js0nnn/diy-power-quality-analyzer/docs/gui_main.png

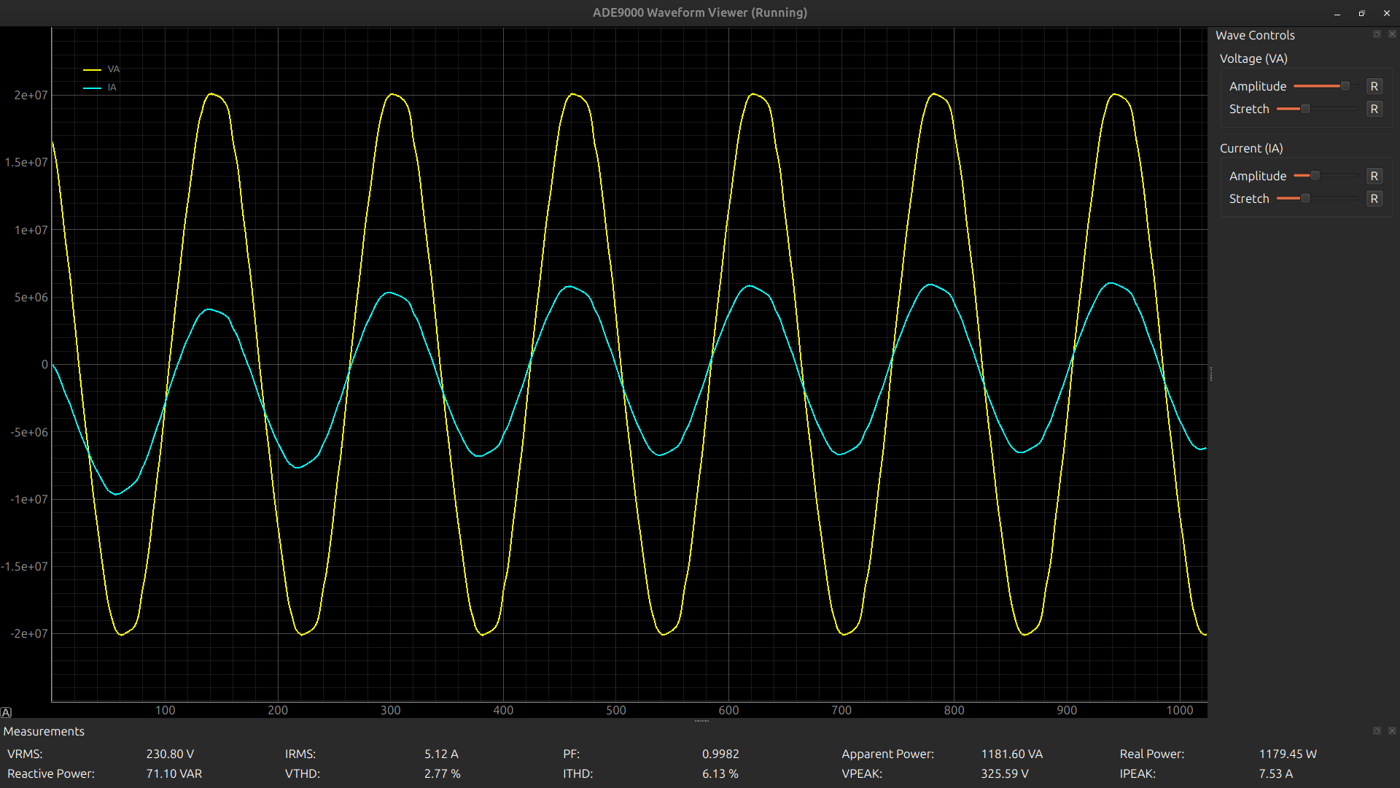
docs/gui_main.png
