js0nnn/diy-power-quality-analyzer/docs/hardware.jpg

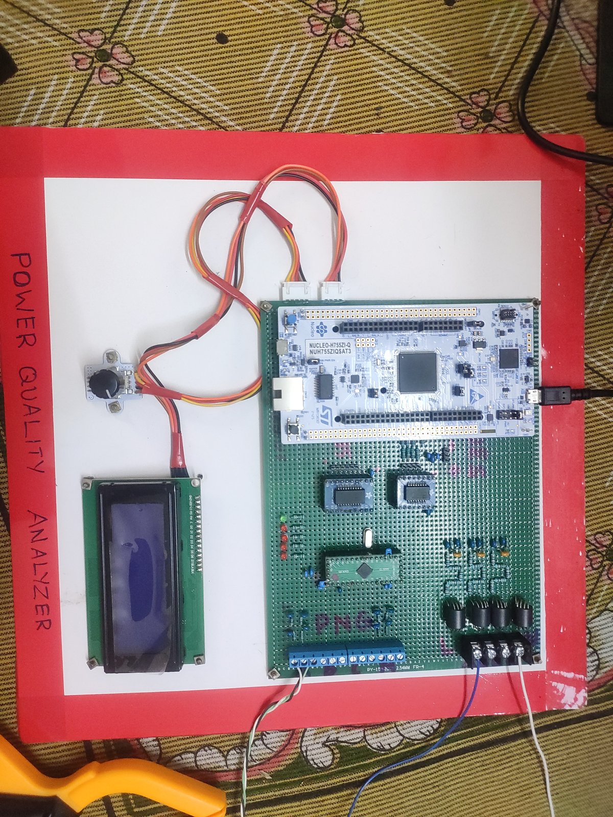
docs/hardware.jpg
