js0nnn/diy-power-quality-analyzer/ADE9000_PQA/ADE9000_PQA.ioc

Mcu.UserName=STM32H755ZITx
PA11.Signal=USB_OTG_FS_DM
PA12.Signal=USB_OTG_FS_DP
PA5.GPIO_Label=ADE9000_SPI1_SCK
PA5.Signal=SPI1_SCK
PA6.GPIO_Label=ADE9000_SPI1_MISO
PA6.Signal=SPI1_MISO
PA8.Signal=USB_OTG_FS_SOF
PA9.Signal=USB_OTG_FS_VBUS
PB0.GPIO_Label=CM7_LD1
PB0.Signal=GPIO_Output
PB10.GPIO_Label=LCD_SCL
PB10.Signal=I2C2_SCL
PB11.GPIO_Label=LCD_SDA
PB11.Signal=I2C2_SDA
PB5.GPIO_Label=ADE9000_SPI1_MOSI
PB5.Signal=SPI1_MOSI
PB6.GPIO_Label=ENCODER_A
PB6.Signal=S_TIM4_CH1
PB7.GPIO_Label=ENCODER_B
PB7.Signal=S_TIM4_CH2
PB8.GPIO_Label=ADE9000_IRQ0
PB8.Signal=GPXTI8
PB9.GPIO_Label=ADE9000_IRQ1
PB9.Signal=GPIO_Input
PC13.Signal=GPIO_Input
PC7.GPIO_Label=ADE9000_ZX
PC7.Signal=GPIO_Input
PD10.GPIO_Label=USB_OTG_FS_PWR_EN
PD10.Signal=GPIO_Output
PD14.GPIO_Label=ADE9000_SPI1_CS
PD14.Signal=GPIO_Output
PD15.GPIO_Label=ADE9000_RESET
PD15.Signal=GPIO_Output
PD5.Signal=USART2_TX
PD6.Signal=USART2_RX
PD7.GPIO_Label=ESP01_RST
PD7.Signal=GPIO_Output
PD8.Signal=USART3_TX
PD9.Signal=USART3_RX
PE11.GPIO_Label=ADE9000_DREADY_INT
PE11.Signal=GPXTI11
PG13.Signal=ETH_TXD0
PG14.GPIO_Label=ENCODER_SW
PG14.Signal=GPXTI14
PG7.GPIO_Label=USB_OTG_FS_OVCR
PG7.Signal=GPXTI7
PG9.GPIO_Label=ADE9000_PM1
PG9.Signal=GPIO_Output
