js0nnn/diy-power-quality-analyzer/ADE9000_PQA/CM7/Core/Inc/main.h

#define ADE9000_SPI1_SCK_Pin GPIO_PIN_5
#define ADE9000_SPI1_SCK_GPIO_Port GPIOA
#define ADE9000_SPI1_MISO_Pin GPIO_PIN_6
#define ADE9000_SPI1_MISO_GPIO_Port GPIOA
#define CM7_LD1_Pin GPIO_PIN_0
#define CM7_LD1_GPIO_Port GPIOB
#define ADE9000_DREADY_INT_Pin GPIO_PIN_11
#define ADE9000_DREADY_INT_GPIO_Port GPIOE
#define ADE9000_DREADY_INT_EXTI_IRQn EXTI15_10_IRQn
#define ADE9000_SPI1_CS_Pin GPIO_PIN_14
#define ADE9000_SPI1_CS_GPIO_Port GPIOD
#define ADE9000_RESET_Pin GPIO_PIN_15
#define ADE9000_RESET_GPIO_Port GPIOD
#define ADE9000_PM1_Pin GPIO_PIN_9
#define ADE9000_PM1_GPIO_Port GPIOG
#define ADE9000_SPI1_MOSI_Pin GPIO_PIN_5
#define ADE9000_SPI1_MOSI_GPIO_Port GPIOB
#define ADE9000_IRQ0_Pin GPIO_PIN_8
#define ADE9000_IRQ0_GPIO_Port GPIOB
#define ADE9000_IRQ0_EXTI_IRQn EXTI9_5_IRQn
