js0nnn/diy-power-quality-analyzer/ADE9000_PQA/Common/Src/esp01_drivers/ESP8266_STM32.c

#include "ESP8266_STM32.h"


ESP8266_ConnectionState ESP_ConnState = ESP8266_DISCONNECTED;   // Default state
static char esp_rx_buffer[2048];
static ESP8266_Status ESP_GetIP(char *ip_buffer, uint16_t buffer_len);
static ESP8266_Status ESP_SendCommand(const char *cmd, const char *ack, uint32_t timeout);

void ESP_Flush(void)
{
    uint8_t ch;
    while (HAL_UART_Receive(&ESP_UART, &ch, 1, 5) == HAL_OK);
}

ESP8266_Status ESP_Init(void)
{
	ESP8266_Status res;
	USER_LOG("Initializing ESP8266...");
	HAL_Delay(1000);

	ESP_Flush();
//	res = ESP_SendCommand("AT+RST\r\n", "OK", 2000);
//    if (res != ESP8266_OK){
//    	DEBUG_LOG("Failed to Reset ESP8266...");
//    	return res;
//    }
//
//    USER_LOG("Waiting 5 Seconds for Reset to Complete...");
//    HAL_Delay(5000);  // wait for reset to complete

    res = ESP_SendCommand("AT\r\n", "OK", 2000);
    if (res != ESP8266_OK){
    	DEBUG_LOG("ESP8266 Not Responding...");
    	return res;
    }

    res = ESP_SendCommand("ATE0\r\n", "OK", 2000); // Disable echo
    if (res != ESP8266_OK){
    	DEBUG_LOG("Disable echo Command Failed...");
    	return res;
    }
    USER_LOG("ESP8266 Initialized Successfully...");
    return ESP8266_OK;
}



ESP8266_Status ESP_MQTT_Publish(const char *topic, const char *payload, uint8_t qos, uint8_t retain)
{

	if (strlen(payload) > 100)
	{
		DEBUG_LOG("Payload too long!\r\n");
	    return ESP8266_ERROR;
	}

    char cmd[512];

    snprintf(cmd, sizeof(cmd),
             "AT+MQTTPUB=0,\"%s\",\"%s\",%d,%d\r\n",
             topic,
             payload,
             qos,
             retain);

    return ESP_SendCommand(cmd, "OK", 5000);
}


ESP8266_Status ESP_MQTT_Connect(const char *client_id,
                               const char *broker_ip,
                               uint16_t port)
{
    char cmd[256];

    USER_LOG("Starting MQTT Setup...");

    /* Single connection mode */
    if (ESP_SendCommand("AT+CIPMUX=0\r\n", "OK", 2000) != ESP8266_OK)
    {
        USER_LOG("CIPMUX failed");
        return ESP8266_ERROR;
    }

    /* Clean previous MQTT session */
    ESP_SendCommand("AT+MQTTCLEAN=0\r\n", "OK", 2000);

    /* Configure MQTT client */
    snprintf(cmd, sizeof(cmd),
             "AT+MQTTUSERCFG=0,1,\"%s\",\"\",\"\",0,0,\"\"\r\n",
             client_id);

    if (ESP_SendCommand(cmd, "OK", 3000) != ESP8266_OK)
    {
        USER_LOG("MQTT USERCFG failed");
        return ESP8266_ERROR;
    }

    /* Connect to broker */
    snprintf(cmd, sizeof(cmd),
             "AT+MQTTCONN=0,\"%s\",%d,0\r\n",
             broker_ip, port);

    if (ESP_SendCommand(cmd, "OK", 8000) != ESP8266_OK)
    {
        USER_LOG("MQTT connection failed");
        return ESP8266_ERROR;
    }

    USER_LOG("MQTT Connected to %s:%d", broker_ip, port);

    return ESP8266_OK;
}


ESP8266_Status ESP_ConnectWiFi(const char *ssid, const char *password, char *ip_buffer, uint16_t buffer_len)
{
    USER_LOG("Setting in Station Mode");
    // reset WiFi
//    ESP_SendCommand("AT+CWQAP\r\n", "OK", 2000);
    // Set in Station Mode
    char cmd[128];
    snprintf(cmd, sizeof(cmd), "AT+CWMODE=1\r\n");

    ESP8266_Status result = ESP_SendCommand(cmd, "OK", 2000); // wait up to 2s
    if (result != ESP8266_OK)
    {
    	USER_LOG("Station Mode Failed.");
        return result;
    }
    
    USER_LOG("Connecting to WiFi SSID: %s", ssid);
    // Send join command
    snprintf(cmd, sizeof(cmd), "AT+CWJAP=\"%s\",\"%s\"\r\n", ssid, password);

    result = ESP_SendCommand(cmd, "WIFI CONNECTED", 10000); // wait up to 10s
    if (result != ESP8266_OK)
    {
    	USER_LOG("WiFi connection failed.");
        ESP_ConnState = ESP8266_NOT_CONNECTED;
        return result;
    }

    USER_LOG("WiFi Connected. Waiting for IP...");
    ESP_ConnState = ESP8266_CONNECTED_NO_IP;
    // Fetch IP with retries inside ESP_GetIP
    result = ESP_GetIP(ip_buffer, buffer_len);
    if (result != ESP8266_OK)
    {
    	USER_LOG("Failed to fetch IP. Status=%d", result);
        return result;
    }

    USER_LOG("WiFi + IP ready: %s", ip_buffer);
    return ESP8266_OK;
}

ESP8266_ConnectionState ESP_GetConnectionState(void)
{
    return ESP_ConnState;
}

static ESP8266_Status ESP_GetIP(char *ip_buffer, uint16_t buffer_len)
{
	DEBUG_LOG("Fetching IP Address...");

    for (int attempt = 1; attempt <= 3; attempt++)
    {
        ESP8266_Status result = ESP_SendCommand("AT+CIFSR\r\n", "OK", 5000);
        if (result != ESP8266_OK)
        {
        	DEBUG_LOG("CIFSR failed on attempt %d", attempt);
            continue;
        }

        char *search = esp_rx_buffer;
        char *last_ip = NULL;

        while ((search = strstr(search, "STAIP,")) != NULL)
        {
            char *ip_start = strstr(search, "STAIP,\"");
            if (ip_start)
            {
                ip_start += 7;
                char *end = strchr(ip_start, '"');
                if (end && ((end - ip_start) < buffer_len))
                {
                    last_ip = ip_start;
                }
            }
            search += 6;
        }

        if (last_ip)
        {
            char *end = strchr(last_ip, '"');
            strncpy(ip_buffer, last_ip, end - last_ip);
            ip_buffer[end - last_ip] = '\0';

            if (strcmp(ip_buffer, "0.0.0.0") == 0)
            {
            	DEBUG_LOG("Attempt %d: IP not ready yet (0.0.0.0). Retrying...", attempt);
                ESP_ConnState = ESP8266_CONNECTED_NO_IP;
                HAL_Delay(1000);
                continue;
            }

            DEBUG_LOG("Got IP: %s", ip_buffer);
            ESP_ConnState = ESP8266_CONNECTED_IP;
            return ESP8266_OK;
        }

        DEBUG_LOG("Attempt %d: Failed to parse STAIP.", attempt);
        HAL_Delay(500);
    }

    DEBUG_LOG("Failed to fetch IP after retries.");
    ESP_ConnState = ESP8266_CONNECTED_NO_IP;  // still connected, but no IP
    return ESP8266_ERROR;
}

static ESP8266_Status ESP_SendCommand(const char *cmd, const char *ack, uint32_t timeout)
{
    uint8_t ch;
    uint16_t idx = 0;
    uint32_t tickstart;
    int found = 0;

    memset(esp_rx_buffer, 0, sizeof(esp_rx_buffer));
    tickstart = HAL_GetTick();

    if (strlen(cmd) > 0)
    {
        DEBUG_LOG("Sending: %s", cmd);
        if (HAL_UART_Transmit(&ESP_UART, (uint8_t*)cmd, strlen(cmd), HAL_MAX_DELAY) != HAL_OK)
            return ESP8266_ERROR;
    }

    while ((HAL_GetTick() - tickstart) < timeout && idx < sizeof(esp_rx_buffer) - 1)
    {
        if (HAL_UART_Receive(&ESP_UART, &ch, 1, 10) == HAL_OK)
        {
            esp_rx_buffer[idx++] = ch;
            esp_rx_buffer[idx]   = '\0';

            // check for ACK
            if (!found && strstr(esp_rx_buffer, ack))
            {
                DEBUG_LOG("Matched ACK: %s", ack);
                found = 1; // mark as found but keep reading
            }

            // handle busy response
            if (strstr(esp_rx_buffer, "busy"))
            {
                DEBUG_LOG("ESP is busy... delaying before retry");
                HAL_Delay(1500);
                idx = 0;
                memset(esp_rx_buffer, 0, sizeof(esp_rx_buffer));
                continue;
            }
        }
    }

    if (found)
    {
        DEBUG_LOG("Full buffer: %s", esp_rx_buffer);
        return ESP8266_OK;
    }

    if (idx == 0)
        return ESP8266_NO_RESPONSE;

    DEBUG_LOG("Timeout or no ACK. Buffer: %s", esp_rx_buffer);
    return ESP8266_TIMEOUT;
}
