js0nnn/diy-power-quality-analyzer/ADE9000_PQA/Common/Src/ade9000_drivers/no_os_util.c

/***************************************************************************//**
 *   @file   no_os_util.c
 *   @brief  Implementation of utility functions.
 *   @author DBogdan (dragos.bogdan@analog.com)
********************************************************************************
 * Copyright 2018(c) Analog Devices, Inc.
 *
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
 * 3. Neither the name of Analog Devices, Inc. nor the names of its
 *    contributors may be used to endorse or promote products derived from this
 *    software without specific prior written permission.
 *
 * THIS SOFTWARE IS PROVIDED BY ANALOG DEVICES, INC. “AS IS” AND ANY EXPRESS OR
 * IMPLIED WARRANTIES, INCLUDING, BUT NOT LIMITED TO, THE IMPLIED WARRANTIES OF
 * MERCHANTABILITY AND FITNESS FOR A PARTICULAR PURPOSE ARE DISCLAIMED. IN NO
 * EVENT SHALL ANALOG DEVICES, INC. BE LIABLE FOR ANY DIRECT, INDIRECT,
 * INCIDENTAL, SPECIAL, EXEMPLARY, OR CONSEQUENTIAL DAMAGES (INCLUDING, BUT NOT
 * LIMITED TO, PROCUREMENT OF SUBSTITUTE GOODS OR SERVICES; LOSS OF USE, DATA,
 * OR PROFITS; OR BUSINESS INTERRUPTION) HOWEVER CAUSED AND ON ANY THEORY OF
 * LIABILITY, WHETHER IN CONTRACT, STRICT LIABILITY, OR TORT (INCLUDING
 * NEGLIGENCE OR OTHERWISE) ARISING IN ANY WAY OUT OF THE USE OF THIS SOFTWARE,
 * EVEN IF ADVISED OF THE POSSIBILITY OF SUCH DAMAGE.
*******************************************************************************/

#include "no_os_util.h"

#include <string.h>
#include <stdlib.h>
#include "errno.h"
extern int no_os_test_bit(int pos, const volatile void * addr);

/**
 * Find first set bit in word.
 */
uint32_t no_os_find_first_set_bit(uint32_t word)
{
	uint32_t first_set_bit = 0;

	while (word) {
		if (word & 0x1)
			return first_set_bit;
		word >>= 1;
		first_set_bit ++;
	}

	return 32;
}

/**
 * Find first set bit in word.
 */
uint64_t no_os_find_first_set_bit_u64(uint64_t word)
{
	uint64_t first_set_bit = 0;

	while (word) {
		if (word & 0x1)
			return first_set_bit;
		word >>= 1;
		first_set_bit ++;
	}

	return 64;
}

/**
 * Find last set bit in word.
 */
uint32_t no_os_find_last_set_bit(uint32_t word)
{
	uint32_t bit = 0;
	uint32_t last_set_bit = 32;

	while (word) {
		if (word & 0x1)
			last_set_bit = bit;
		word >>= 1;
		bit ++;
	}

	return last_set_bit;
}

/**
 * Find last set bit in word.
 */
uint64_t no_os_find_last_set_bit_u64(uint64_t word)
{
	uint64_t bit = 0;
	uint64_t last_set_bit = 64;

	while (word) {
		if (word & 0x1)
			last_set_bit = bit;
		word >>= 1;
		bit ++;
	}

	return last_set_bit;
}

/**
 * Locate the closest element in an array.
 */
uint32_t no_os_find_closest(int32_t val,
			    const int32_t *array,
			    uint32_t size)
{
	int32_t diff = abs(array[0] - val);
	uint32_t ret = 0;
	uint32_t i;

	for (i = 1; i < size; i++) {
		if (abs(array[i] - val) < diff) {
			diff = abs(array[i] - val);
			ret = i;
		}
	}

	return ret;
}

/**
 * Shift the value and apply the specified mask.
 */
uint32_t no_os_field_prep(uint32_t mask, uint32_t val)
{
	return (val << no_os_find_first_set_bit(mask)) & mask;
}

uint64_t no_os_field_prep_u64(uint64_t mask, uint64_t val)
{
	return (val << no_os_find_first_set_bit_u64(mask)) & mask;
}

/**
 * Get a field specified by a mask from a word.
 */
uint32_t no_os_field_get(uint32_t mask, uint32_t word)
{
	return (word & mask) >> no_os_find_first_set_bit(mask);
}

/**
 * Produce the maximum value representable by a field
 */
uint32_t no_os_field_max(uint32_t mask)
{
	// Find the first set bit to determine the shift position
	uint32_t first_set_bit = no_os_find_first_set_bit(mask);

	// Shift the mask to the right by the position of the first set bit
	uint32_t shifted_mask = mask >> first_set_bit;

	return shifted_mask;
}

/**
 * Produce the maximum value representable by a field
 */
uint64_t no_os_field_max_u64(uint64_t mask)
{
	// Find the first set bit to determine the shift position
	uint64_t first_set_bit = no_os_find_first_set_bit_u64(mask);

	// Shift the mask to the right by the position of the first set bit
	uint64_t shifted_mask = mask >> first_set_bit;

	return shifted_mask;
}


/**
 * Log base 2 of the given number.
 */
int32_t no_os_log_base_2(uint32_t x)
{
	return no_os_find_last_set_bit(x);
}

/**
 * Find greatest common divisor of the given two numbers.
 */
uint32_t no_os_greatest_common_divisor(uint32_t a,
				       uint32_t b)
{
	uint32_t div;

	if ((a == 0) || (b == 0))
		return no_os_max(a, b);

	while (b != 0) {
		div = a % b;
		a = b;
		b = div;
	}

	return a;
}

uint64_t no_os_greatest_common_divisor_u64(uint64_t a,
		uint64_t b)
{
	uint64_t div;

	if ((a == 0) || (b == 0))
		return no_os_max(a, b);

	while (b != 0) {
		div = a % b;
		a = b;
		b = div;
	}

	return a;
}

/**
 * Find lowest common multiple of the given two numbers.
 */
uint32_t no_os_lowest_common_multiple(uint32_t a, uint32_t b)
{
	if (a && b)
		return (a / no_os_greatest_common_divisor(a, b)) * b;
	else
		return 0;
}

/**
 * Calculate best rational approximation for a given fraction.
 */
void no_os_rational_best_approximation(uint32_t given_numerator,
				       uint32_t given_denominator,
				       uint32_t max_numerator,
				       uint32_t max_denominator,
				       uint32_t *best_numerator,
				       uint32_t *best_denominator)
{
	uint32_t gcd;

	gcd = no_os_greatest_common_divisor(given_numerator, given_denominator);

	*best_numerator = given_numerator / gcd;
	*best_denominator = given_denominator / gcd;

	if ((*best_numerator > max_numerator) ||
	    (*best_denominator > max_denominator)) {
		*best_numerator = 0;
		*best_denominator = 0;
	}
}

void no_os_rational_best_approximation_u64(uint64_t given_numerator,
		uint64_t given_denominator,
		uint64_t max_numerator,
		uint64_t max_denominator,
		uint64_t *best_numerator,
		uint64_t *best_denominator)
{
	uint64_t gcd;

	gcd = no_os_greatest_common_divisor_u64(given_numerator, given_denominator);

	*best_numerator = given_numerator / gcd;
	*best_denominator = given_denominator / gcd;

	if ((*best_numerator > max_numerator) ||
	    (*best_denominator > max_denominator)) {
		*best_numerator = 0;
		*best_denominator = 0;
	}
}

/**
 * Calculate the number of set bits (8-bit size).
 */
unsigned int no_os_hweight8(uint8_t word)
{
	uint32_t count = 0;

	while (word) {
		if (word & 0x1)
			count++;
		word >>= 1;
	}

	return count;
}

/**
 * Calculate the number of set bits (16-bit size).
 */
unsigned int no_os_hweight16(uint16_t word)
{
	return no_os_hweight8(word >> 8) +
	       no_os_hweight8(word);
}

/**
 * Calculate the number of set bits (32-bit size).
 */
unsigned int no_os_hweight32(uint32_t word)
{
	return no_os_hweight16(word >> 16) +
	       no_os_hweight16(word);
}

/**
 * Calculate the quotient and the remainder of an integer division.
 */
uint64_t no_os_do_div(uint64_t* n,
		      uint64_t base)
{
	uint64_t mod = 0;

	mod = *n % base;
	*n = *n / base;

	return mod;
}

/**
 * Unsigned 64bit divide with 64bit divisor and remainder
 */
uint64_t no_os_div64_u64_rem(uint64_t dividend, uint64_t divisor,
			     uint64_t *remainder)
{
	*remainder = dividend % divisor;

	return dividend / divisor;
}

/**
 * Unsigned 64bit divide with 32bit divisor with remainder
 */
uint64_t no_os_div_u64_rem(uint64_t dividend, uint32_t divisor,
			   uint32_t *remainder)
{
	*remainder = no_os_do_div(&dividend, divisor);

	return dividend;
}

/**
 * Signed 64bit divide with 32bit divisor with remainder
 */
int64_t no_os_div_s64_rem(int64_t dividend, int32_t divisor, int32_t *remainder)
{
	*remainder = dividend % divisor;
	return dividend / divisor;
}

/**
 * Unsigned 64bit divide with 32bit divisor
 */
uint64_t no_os_div_u64(uint64_t dividend, uint32_t divisor)
{
	uint32_t remainder;

	return no_os_div_u64_rem(dividend, divisor, &remainder);
}

/**
 * Signed 64bit divide with 32bit divisor
 */
int64_t no_os_div_s64(int64_t dividend, int32_t divisor)
{
	int32_t remainder;
	return no_os_div_s64_rem(dividend, divisor, &remainder);
}

/**
 * Converts from string to int32_t
 * @param *str
 * @return int32_t
 */
int32_t no_os_str_to_int32(const char *str)
{
	char *end;
	int32_t value = strtol(str, &end, 0);

	if (end == str)
		return -EINVAL;
	else
		return value;
}

/**
 * Converts from string to uint32_t
 * @param *str
 * @return uint32_t
 */
uint32_t no_os_str_to_uint32(const char *str)
{
	char *end;
	uint32_t value = strtoul(str, &end, 0);

	if (end == str)
		return -EINVAL;
	else
		return value;
}

void no_os_put_unaligned_be16(uint16_t val, uint8_t *buf)
{
	buf[1] = val & 0xFF;
	buf[0] = val >> 8;
}

uint16_t no_os_get_unaligned_be16(uint8_t *buf)
{
	return buf[1] | ((uint16_t)buf[0] << 8);
}

void no_os_put_unaligned_le16(uint16_t val, uint8_t *buf)
{
	buf[0] = val & 0xFF;
	buf[1] = val >> 8;
}

uint16_t no_os_get_unaligned_le16(uint8_t *buf)
{
	return buf[0] | ((uint16_t)buf[1] << 8);
}

void no_os_put_unaligned_be24(uint32_t val, uint8_t *buf)
{
	buf[2] = val & 0xFF;
	buf[1] = (val >> 8) & 0xFF;
	buf[0] = val >> 16;
}

uint32_t no_os_get_unaligned_be24(uint8_t *buf)
{
	return buf[2] | ((uint16_t)buf[1] << 8) | ((uint32_t)buf[0] << 16);
}

void no_os_put_unaligned_le24(uint32_t val, uint8_t *buf)
{
	buf[0] = val & 0xFF;
	buf[1] = (val >> 8) & 0xFF;
	buf[2] = val >> 16;
}

uint32_t no_os_get_unaligned_le24(uint8_t *buf)
{
	return buf[0] | ((uint16_t)buf[1] << 8) | ((uint32_t)buf[2] << 16);
}

void no_os_put_unaligned_be32(uint32_t val, uint8_t *buf)
{
	buf[3] = val & 0xFF;
	buf[2] = (val >> 8) & 0xFF;
	buf[1] = (val >> 16) & 0xFF;
	buf[0] = val >> 24;
}

uint32_t no_os_get_unaligned_be32(uint8_t *buf)
{
	return buf[3] | ((uint16_t)buf[2] << 8) | ((uint32_t)buf[1] << 16)
	       | ((uint32_t)buf[0] << 24);
}

void no_os_put_unaligned_le32(uint32_t val, uint8_t *buf)
{
	buf[0] = val & 0xFF;
	buf[1] = (val >> 8) & 0xFF;
	buf[2] = (val >> 16) & 0xFF;
	buf[3] = val >> 24;
}

uint32_t no_os_get_unaligned_le32(uint8_t *buf)
{
	return buf[0] | ((uint16_t)buf[1] << 8) | ((uint32_t)buf[2] << 16)
	       | ((uint32_t)buf[3] << 24);
}

void no_os_put_unaligned_be64(uint64_t val, uint8_t *buf)
{
	buf[7] = val & 0xFF;
	buf[6] = (val >> 8) & 0xFF;
	buf[5] = (val >> 16) & 0xFF;
	buf[4] = (val >> 24) & 0xFF;
	buf[3] = (val >> 32) & 0xFF;
	buf[2] = (val >> 40) & 0xFF;
	buf[1] = (val >> 48) & 0xFF;
	buf[0] = val >> 56;
}

uint64_t no_os_get_unaligned_be64(uint8_t *buf)
{
	return buf[7] | ((uint16_t)buf[6] << 8) | ((uint32_t)buf[5] << 16)
	       | ((uint32_t)buf[4] << 24) | ((uint64_t)buf[3] << 32)
	       | ((uint64_t)buf[2] << 40) | ((uint64_t)buf[1] << 48)
	       | ((uint64_t)buf[0] << 56);
}

void no_os_put_unaligned_le64(uint64_t val, uint8_t *buf)
{
	buf[0] = val & 0xFF;
	buf[1] = (val >> 8) & 0xFF;
	buf[2] = (val >> 16) & 0xFF;
	buf[3] = (val >> 24) & 0xFF;
	buf[4] = (val >> 32) & 0xFF;
	buf[5] = (val >> 40) & 0xFF;
	buf[6] = (val >> 48) & 0xFF;
	buf[7] = val >> 56;
}

uint64_t no_os_get_unaligned_le64(uint8_t *buf)
{
	return buf[0] | ((uint16_t)buf[1] << 8) | ((uint32_t)buf[2] << 16)
	       | ((uint32_t)buf[3] << 24) | ((uint64_t)buf[4] << 32)
	       | ((uint64_t)buf[5] << 40) | ((uint64_t)buf[6] << 48)
	       | ((uint64_t)buf[7] << 56);
}

int16_t no_os_sign_extend16(uint16_t value, int index)
{
	uint8_t shift = 15 - index;
	return (int16_t)(value << shift) >> shift;
}

int32_t no_os_sign_extend32(uint32_t value, int index)
{
	uint8_t shift = 31 - index;
	return (int32_t)(value << shift) >> shift;
}

uint64_t no_os_mul_u32_u32(uint32_t a, uint32_t b)
{
	return (uint64_t)a * b;
}

uint64_t no_os_mul_u64_u32_shr(uint64_t a, uint32_t mul, unsigned int shift)
{
	uint32_t ah, al;
	uint64_t ret;

	al = a;
	ah = a >> 32;

	ret = no_os_mul_u32_u32(al, mul) >> shift;
	if (ah)
		ret += no_os_mul_u32_u32(ah, mul) << (32 - shift);

	return ret;
}

uint64_t no_os_mul_u64_u32_div(uint64_t a, uint32_t mul, uint32_t divisor)
{
	int i;
	uint64_t low, high, temp, rem;
	uint32_t a_high = a >> 32;
	uint32_t a_low = a & 0xFFFFFFFF;
	uint64_t result = 0;
	uint64_t low_low = no_os_mul_u32_u32(a_low, mul);
	uint64_t high_low =  no_os_mul_u32_u32(a_high, mul);

	low = low_low + ((high_low & 0xFFFFFFFF) << 32);
	high = (high_low >> 32) + (low_low >> 32);

	rem = high;

	for (i = 0; i < 64; i++) {
		/* Shift remainder left and add the next bit from low */
		rem = (rem << 1) | (low >> 63);
		low <<= 1;

		/* Compare the remainder with the divisor */
		if (rem >= divisor) {
			rem -= divisor;
			temp = (uint64_t)1 << (63 - i);
			result |= temp;
		}
	}
	return result;
}

/**
 * @brief Check big endianess of the host processor.
 * @return Big endianess status (true/false)
 */
bool no_os_is_big_endian(void)
{
	uint16_t a = 0x0100;
	return (bool) * (uint8_t *)&a;
}

/* @brief Swap bytes in a buffer with a given step
 *        Swap with step of 2:
 *        AA BB CC DD EE FF 00 11 becomes
 *        BB AA DD CC FF EE 11 00
 *        Swap with step of 3:
 *        AA BB CC DD EE FF 00 11 22 becomes
 *        CC BB AA FF EE DD 22 11 00
 *        etc.
 * @param buf - Input buffer to be swapped.
 * @param bytes - Number of bytes.
 * @param step - Number of steps.
 * @return None
 */
void no_os_memswap64(void *buf, uint32_t bytes, uint32_t step)
{
	uint8_t * p = buf;
	uint32_t i, j;
	uint8_t temp[8];

	if (step < 2 || step > 8 || bytes < step || bytes % step != 0)
		return;

	for (i = 0; i < bytes; i += step) {
		memcpy(temp, p, step);
		for (j = step; j > 0; j--) {
			*p++ = temp[j - 1];
		}
	}
}
