js0nnn/diy-power-quality-analyzer/(commit log)

2026-10-17 Initial commit: DIY power quality analyzer
    Hand-soldered ADE9000 on zero PCB with a dual-core STM32H755:
    SPI DMA waveform capture, CRC16 UART streaming at 921600 baud,
    and a PyQt6 visualizer. Split out of js0nnn/ade9000-stm32h755.
2026-10-17 Add LCD and rotary encoder UI on CM4, on-device power maths on CM7
    CM7 computes RMS, P, Q, S, PF, peaks and THD from each waveform frame
    (a C port of the visualizer maths) and publishes them to SRAM4 through
    a seqlock. CM4 drives a 20x4 PCF8574 LCD on I2C2 and a TIM4 rotary
    encoder with four pages and a menu, replacing the SPI bring-up test.
2026-10-17 Use the original full firmware: LCD, encoder and MQTT together
    Replace the reconstructed CM4/CM7 code with the original project
    (OpenAMP, I2C_LCD library, ESP8266 driver, shared_mem.h) and bring
    back the parts that were commented out during the MQTT tests:
    - CM4: LCD pages, menu and rotary encoder run alongside Wi-Fi/MQTT
    - TIM4 encoder init restored in a USER CODE block (HAL TIM enabled)
    - button EXTI only sets a flag; the main loop redraws
    - MQTT publishes the latest values once a second instead of every
    frame, so the blocking AT commands no longer starve the UI and the
    LCD no longer races MQTT for the params_ready flag
    - MQTT payload carries THD from the ADE9000 registers
    - ITHD show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
2026-10-17 Add real-load measurements: waveforms and harmonics
    Oven (resistive), laptop charger (SMPS) and mixer grinder (motor)
    waveforms with their current harmonic spectra, a summary table of the
    measured values, under/overvoltage detection captures and LCD photos.
