js0nnn/diy-power-quality-analyzer/(notices)

Notices in the files:
ADE9000_PQA/CM7/Core/Src/main.c:
Copyright (c) 2026 STMicroelectronics.
All rights reserved.
This software is licensed under terms that can be found in the LICENSE file
